zhu-chengdong/rov-v1-hardwarex/docs/author_confirmed_updates.md

# v0.1.1确认资料与更正

本版将既有作者确认写入说明，包括无屏蔽Cat5、两端T568B、PWM1—8位置、TELEM1、PM02配套线、10/16/14 AWG、M5端子、紧固件铜柱、左右相机、原套件与后来FFC、6×6标定板与3×3 GT板、人工选图及已有参数使用情况。默认功率、默认风扇和相机命令均沿用，不重复索取当前读数。

R9成本和原币来源已同步，6S电池为GBP147.26现价参考，历史GBP151保留。原温度数据、CAD和全部27项离线工程文件保持已有内容。本轮仅补齐说明、对应索引和原先缺失的元数据JSON，没有运行工程程序。
