zhu-chengdong/rov-v1-hardwarex/hardware/dxf_circle_coordinates.csv

设计文件 | 圆实体序号 | 圆心X_mm_文件坐标 | 圆心Y_mm_文件坐标 | 直径_mm_设计值 | 图层 | 文件SHA256 | 证据性质
中间第二层.dxf | 1 | 5.0 | -5.0 | 3.5 | 0 | e1be11a05163d77e4fd96c762ded78b1e10967b86603280863bbd9c125fb629a | DXF几何，非实测与公差
中间第二层.dxf | 2 | 105.0 | -5.0 | 3.5 | 0 | e1be11a05163d77e4fd96c762ded78b1e10967b86603280863bbd9c125fb629a | DXF几何，非实测与公差
中间第二层.dxf | 3 | 20.0 | -105.0 | 3.5 | 0 | e1be11a05163d77e4fd96c762ded78b1e10967b86603280863bbd9c125fb629a | DXF几何，非实测与公差
中间第二层.dxf | 4 | 105.0 | -105.0 | 3.5 | 0 | e1be11a05163d77e4fd96c762ded78b1e10967b86603280863bbd9c125fb629a | DXF几何，非实测与公差
中间第二层.dxf | 5 | 10.0 | -40.0 | 3.5 | 0 | e1be11a05163d77e4fd96c762ded78b1e10967b86603280863bbd9c125fb629a | DXF几何，非实测与公差
中间第二层.dxf | 6 | 58.5 | -40.0 | 3.500000000000014 | 0 | e1be11a05163d77e4fd96c762ded78b1e10967b86603280863bbd9c125fb629a | DXF几何，非实测与公差
中间第二层.dxf | 7 | 16.0 | -92.0 | 3.5 | 0 | e1be11a05163d77e4fd96c762ded78b1e10967b86603280863bbd9c125fb629a | DXF几何，非实测与公差
前盖板.dxf | 1 | 0.0 | 100.0 | 6.000000000000002 | 0 | 2d4afc3d615f69fe52117c536fb832e73912f7cb123064bd589a319040ec1ef5 | DXF几何，非实测与公差
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
