zhu-chengdong/rov-v1-hardwarex/hardware/wiring/V1_COMMUNICATION_CONTROL_ARCHITECTURE.png

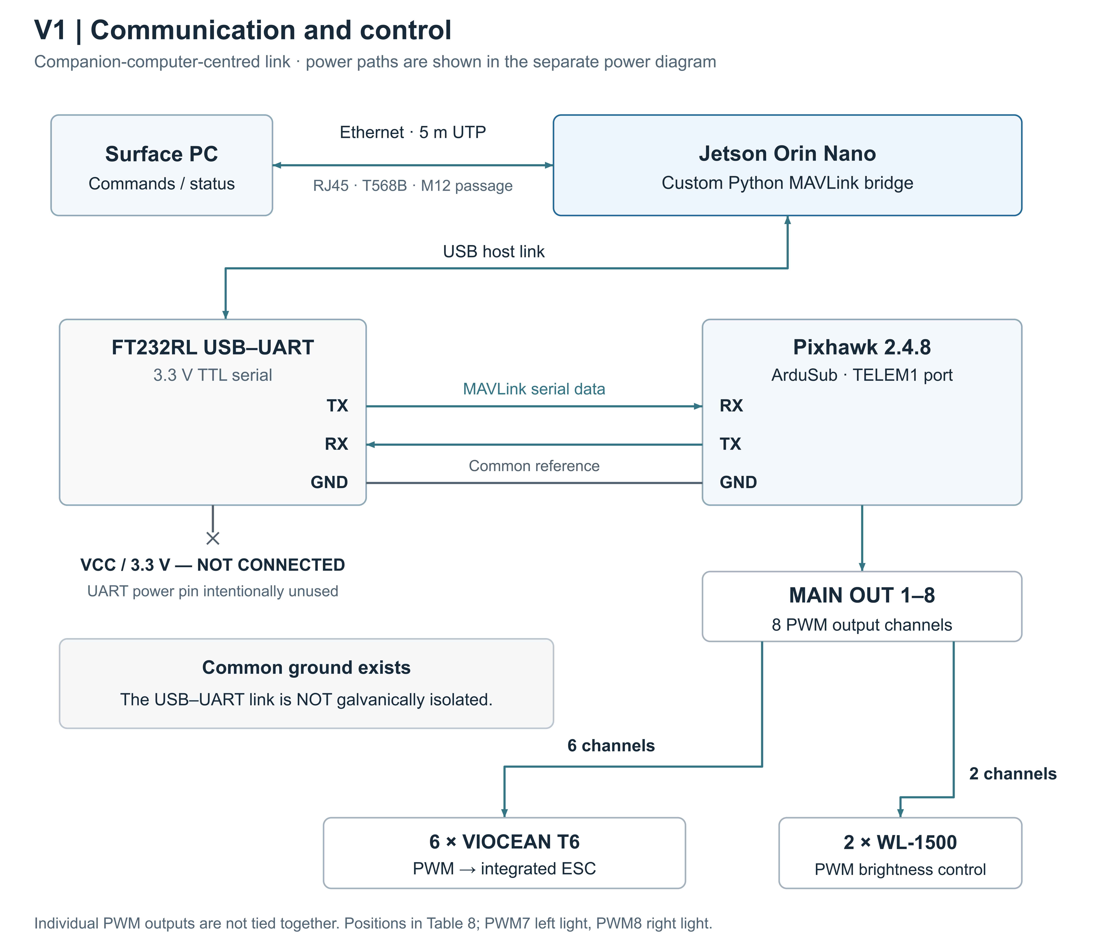
hardware/wiring/V1_COMMUNICATION_CONTROL_ARCHITECTURE.png
