zhu-chengdong/rov-v1-hardwarex/hardware/wiring/V1_POWER_ARCHITECTURE.png

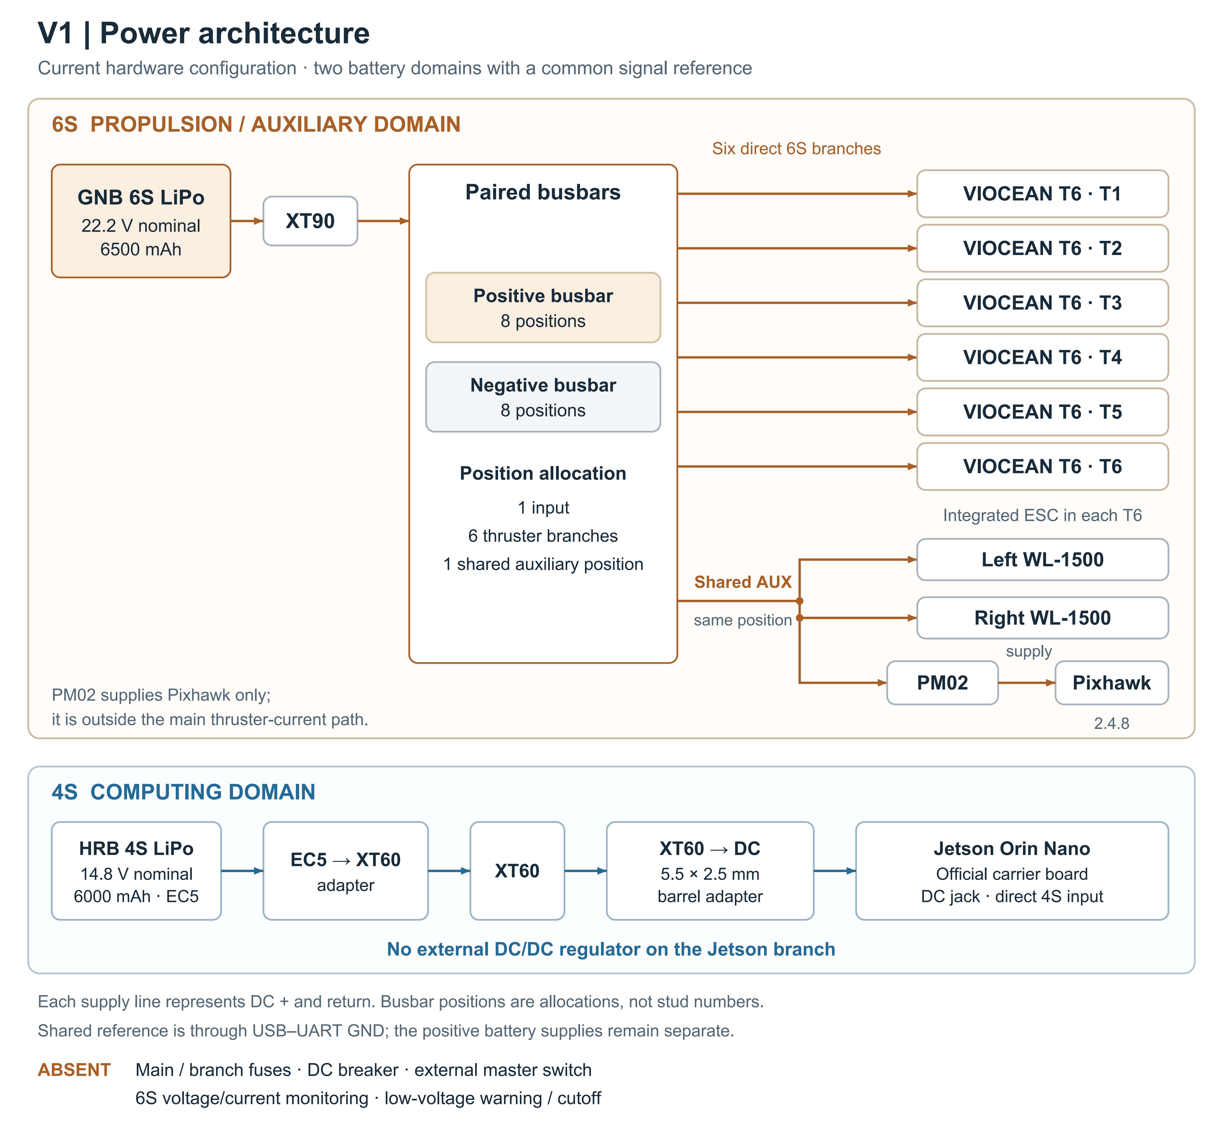
hardware/wiring/V1_POWER_ARCHITECTURE.png
