zhu-chengdong/rov-v1-hardwarex/docs/BOM.md

# R9成本与价格依据

正文、规格表及表3—7统一采用GBP。基础平台估算GBP1130.65；可选MTi-3增加GBP433.54；已列合计GBP1564.19。MTi-3不计入基础平台。地面PC和手柄、可复用工具、GT设施及未记录的额外USB、税运与工时单列。

沿用2026年11月3日ECB汇率，1 EUR对应GBP0.83358、CNY7.4590、USD1.1179。原币、计价组和包含关系见BOM_cost_basis.csv，本版合计按未舍入的原币换算值求和。

6S电池参考成本按作者本轮要求改为GBP147.26。来源为https://www.amazon.co.uk/dp/B0HJQRMZQK?th=1 的6S 6500mAh XT90选项，核对日期2026年11月3日。页面品牌为ZHGLIOZ、标题写For GNB，仅作为同规格现价参考；原GNB电池历史购价GBP151.00作为历史成本另行保留，不把现价改写成历史实付。

作者已确认C03近似CNY50、C12紧固件及铜柱整组CNY50、C30连接与固定耗材整组CNY100。Jetson学校渠道购价GBP189.94、B0266购价USD164.99、M10组合CNY194、M12件CNY27.16和可选MTi-3购价CNY3879.38均按已有回答登记。整组估算保持估算性质，不分摊为每颗螺母的实付金额。

本版v0.1.1更新成本及接线说明，旧版v0.1.0完整包保留原值。硬件正式DOI尚未建立，工程资料发布不表示论文已投稿。

| ID | Component | Quantity | Pricing unit | Line cost GBP | Price basis | Source | Material type |
|---|---|---|---|---|---|---|---|
| C01 | HMY亚克力舱、配套O-ring及前后端盖 | 1套 | 原物品或原费用组 | 66.374604 | 作者报告历史购价 | https://item.taobao.com/item.htm?id=583246672338 | 聚合物 |
| C02 | SLA树脂外框，5类8主件 | 1套 | 原物品或原费用组 | 95.999717 | 三笔SLA订单合计 | 淘宝代打印及嘉立创 | 聚合物 |
| C03 | 5 mm亚克力载荷架及双目架 | 1套 | 原物品或原费用组 | 5.587746 | 作者确认的近似加工费 | 商业激光切割，来源未记录；作者说明实际不到100元，按50元近似记录 | 聚合物 |
| C04 | 8 mm亚克力前盖，Ø220 | 1 | 并入C01 |  | 已计入C01 | 随C01，含现有全部开孔加工 | 聚合物 |
| C05 | 8 mm亚克力后盖，10×M10及中央M12 | 1 | 并入C01 |  | 已计入C01 | 随C01，含现有全部开孔加工 | 聚合物 |
| C06 | M10穿舱件组合，8空心加2封堵；空心通孔6.5 mm | 10件组合 | 原物品或原费用组 | 21.680456 | 作者确认购价 | https://item.taobao.com/item.htm?id=638960016847；作者本轮确认所列价格 | 非特定 |
| C07 | M10实心封堵，包含于C06 | 2 | 并入C06 |  | 已计入C06 | 同C06 | 非特定 |
| C08 | M12空心穿舱件，内部通孔8.5 mm | 1 | 原物品或原费用组 | 3.035264 | 作者确认购价 | https://item.taobao.com/item.htm?id=638960016847；作者本轮确认所列价格 | 非特定 |
| C09 | VIOCEAN MF-01环氧胶 | 包装数量待补 | 原物品或原费用组 | 9.247720 | 作者报告历史购价 | https://item.taobao.com/item.htm?id=583249268979 | 聚合物 |
| C10 | 316L M5×45端盖螺栓 | 16 | 并入C12 |  | 已计入C12 | 来源未记录 | 金属 |
| C11 | 316L M5螺母及垫片 | 16位置 | 并入C12 |  | 已计入C12 | 来源未记录 | 金属 |
| C12 | 结构紧固件与铜柱费用组 | 明细见表A.3 | 原物品或原费用组 | 5.587746 | 作者给定整组估算 | 来源未记录；螺丝、螺母及铜柱整组50元，作者估算 | 金属 |
| C13 | B0266，2×OV9281、原镜头及Camarray | 1套 | 原物品或原费用组 | 123.027430 | 作者确认购价 | https://www.arducam.com/arducam-1mp-stereo-camera-for-raspberry-pi-nvidia-jetson-nano-xavier-nx-dual-ov9281-monochrome-global-shutter-camera-module.html；作者确认USD164.99，不再仅标供应商报价 | 非特定 |
| C14 | B0266标准CSI及同步附件 | 1组 | 并入C13 |  | 已计入C13 | B0266套件随附；后购FFC来源 https://item.szlcsc.com/11651.html | 非特定 |
| C15 | Jetson Orin Nano 8GB开发套件 | 1套 | 原物品或原费用组 | 189.940000 | 作者确认学校折扣供货价 | 作者确认学校渠道供货商折扣价GBP189.94，原供应商金额已确认 | 非特定 |
| C16 | WD_BLACK SN7100 1TB NVMe | 1 | 原物品或原费用组 | 65.470000 | 作者报告历史购价 | 历史来源未记录 | 非特定 |
| C17 | GNB 6S 6500 mAh LiPo，XT90 | 1 | 原物品或原费用组 | 147.260000 | 2026-11-03现价参考 | Amazon 6S 6500mAh XT90选项，2026-11-03核价GBP147.26，https://www.amazon.co.uk/dp/B0HJQRMZQK?th=1；页面品牌ZHGLIOZ、标题For GNB，仅作同规格现价参考，不证明原GNB品牌身份；原台账历史购价GBP151.00保留于旧版 | 非特定 |
| C18 | HRB 4S 6000 mAh LiPo，EC5 | 1 | 原物品或原费用组 | 30.000000 | 作者报告历史购价 | Amazon历史购入 | 非特定 |
| C19 | EC5-to-XT60转接线 | 1 | 并入C30 |  | 已计入C30 | 同门代购 | 非特定 |
| C20 | XT60-to-DC5.5×2.5 mm兼容成品线，12 cm | 安装1 | 原物品或原费用组 | 1.536630 | 两条采购包等额分摊 | 来源未记录 | 非特定 |
| C21 | XT90母头10 AWG成品输入线 | 另购量待补 | 并入C30 |  | 已计入C30 | https://detail.tmall.com/item.htm?id=15100343646 | 非特定 |
| C22 | 正负8位M5配电铜排 | 1套 | 原物品或原费用组 | 15.042213 | 作者报告历史购价 | 淘宝，链接未记录 | 非特定 |
| C23 | Pixhawk 2.4.8兼容板，无GPS | 1 | 原物品或原费用组 | 44.143196 | 作者报告历史购价 | 淘宝，无明确品牌 | 非特定 |
| C24 | PM02 V3及配套POWER供电线 | 1套 | 原物品或原费用组 | 15.980955 | 作者报告历史购价 | 淘宝，厂牌待补 | 非特定 |
| C25 | T6集成ESC推进器，3正桨3反桨，直接固定框架 | 6 | 原物品或原费用组 | 167.434584 | 作者报告历史购价 | https://item.taobao.com/item.htm?id=583231725735 | 非特定 |
| C26 | WL-1500白光灯及随灯夹具 | 2 | 原物品或原费用组 | 79.624268 | 作者报告历史购价 | https://item.taobao.com/item.htm?id=663915287742 | 非特定 |
| C27 | FT232RL USB-UART，3.3 V TTL，1 m | 1 | 原物品或原费用组 | 2.648592 | 作者报告历史购价 | 来源未记录 | 非特定 |
| C28 | 无屏蔽防水五类以太网系缆 | 5 m | 原物品或原费用组 | 7.286421 | 作者报告历史购价 | 作者原来源 https://item.taobao.com/item.htm?id=542224330087；两端T568B | 非特定 |
| C29 | 超五类RJ45水晶头 | 安装2 | 并入C30 |  | 已计入C30 | https://detail.tmall.com/item.htm?id=17914441696；安装两只 | 非特定 |
| C30 | 连接器、导线、焊接热缩及固定耗材组 | 1组，整批计价 | 原物品或原费用组 | 11.175493 | 作者给定整组估算 | https://detail.tmall.com/item.htm?id=15100343646；https://detail.tmall.com/item.htm?id=742432916778；https://item.taobao.com/item.htm?id=843048972026；https://item.taobao.com/item.htm?id=687928659037&sku_properties=31309%3A3221908；未单列增量费用未记录；作者给定未单列线材、接头、端子、热缩与固定耗材整组100元，不按单颗螺母分摊 | 非特定 |
| C31 | 可移除双面胶及热熔胶 | 用量待补 | 并入C30 |  | 已计入C30 | 来源未记录 | 聚合物 |
| C32 | 名义100 g铅块，归档配平 | 17块 | 原物品或原费用组 | 22.570025 | 商品页推算 | 原页面来源未记录 | 金属 |
| C34 | WL-1500随灯夹具 | 2件 | 并入C26 |  | 已计入C26 | https://item.taobao.com/item.htm?id=663915287742 | 非特定 |
| O01 | Xsens MTi-3-8A7G6及USB接口 | 1套 | 原物品或原费用组 | 433.539828 | 作者报告购价 | 作者查得MTi-3原购价CNY3879.38；归属可选模块，不计机器人本体 | 非特定 |
| O02 | MTi-3三组M2.5×15铜柱及额外USB附件 | 铜柱3组；USB附件另核 | 未单列 |  | 未记录 | 三组固定铜柱按C12整批费用处理；额外USB附件未单列价格，不重复计算随附件 | 非特定 |
| S01 | MF-01配套胶枪 | 1 | 原物品或原费用组 | 1.493046 | 作者报告历史购价 | 来源待补 | 非特定 |
| S02 | 格氏智能充电器，支持2S—6S | 1台 | 原物品或原费用组 | 25.189561 | 作者报告历史购价 | 作者报告历史购入 | 非特定 |
| S03 | 地面PC及映射手柄 | 1套 | 未单列 |  | 未记录 | 实际使用XInput Controller #1；PC及手柄具体型号、费用待补 | 非特定 |
| S04 | RJ45压接、焊接和紧固工具 | 待补 | 未单列 |  | 未记录 | 来源待补 | 非特定 |
| S05 | 第二条XT60-to-DC线，备件 | 1 | 原物品或原费用组 | 1.536630 | 两条采购包等额分摊 | 同C20 | 非特定 |
| G01 | OV2311上方单目相机 | 1 | 未单列 |  | 未记录 | Arducam，套件SKU待补 | 非特定 |
| G02 | AprilTag阵列及板材 | 1组 | 未单列 |  | 未记录 | 制作来源待补 | 非特定 |
| G03 | 约0.7 m支撑杆及连接附件 | 4杆及附件 | 未单列 |  | 未记录 | 来源待补 | 非特定 |
| G04 | 临时砖块及铁丝 | 买3砖，用2 | 原物品或原费用组 | 0.223510 | 采购包约数，实用分摊未知 | 通用建材 | 非特定 |
| G05 | 实验网络交换机 | 1 | 未单列 |  | 未记录 | 型号和来源待补 | 非特定 |
| G06 | 水池及GT安装采集配套 | 范围待补 | 未单列 |  | 未记录 | 共用或借用归属待补 | 非特定 |
