zhu-chengdong/rov-v1-hardwarex/docs/BOM_cost_basis.csv

ID | 范围 | 部件 | 数量或计价单位 | 原币种 | 原币行金额 | 价格性质 | 费用归属 | 报告行金额_GBP | 来源
C01 | 基础平台 | HMY亚克力舱、配套O-ring及前后端盖 | 1套 | CNY | 593.93 | 作者报告历史购价 | 单列 | 66.374604 | https://item.taobao.com/item.htm?id=583246672338
C02 | 基础平台 | SLA树脂外框，5类8主件 | 1套 | CNY | 859.02 | 三笔SLA订单合计 | 单列 | 95.999717 | 淘宝代打印及嘉立创
C03 | 基础平台 | 5 mm亚克力载荷架及双目架 | 1套 | CNY | 50.0 | 作者确认的近似加工费 | 单列 | 5.587746 | 商业激光切割，来源未记录；作者说明实际不到100元，按50元近似记录
C04 | 基础平台 | 8 mm亚克力前盖，Ø220 | 1 |  |  | 已计入C01 | C01 |  | 随C01，含现有全部开孔加工
C05 | 基础平台 | 8 mm亚克力后盖，10×M10及中央M12 | 1 |  |  | 已计入C01 | C01 |  | 随C01，含现有全部开孔加工
C06 | 基础平台 | M10穿舱件组合，8空心加2封堵；空心通孔6.5 mm | 10件组合 | CNY | 194.0 | 作者确认购价 | 单列 | 21.680456 | https://item.taobao.com/item.htm?id=638960016847；作者本轮确认所列价格
C07 | 基础平台 | M10实心封堵，包含于C06 | 2 |  |  | 已计入C06 | C06 |  | 同C06
C08 | 基础平台 | M12空心穿舱件，内部通孔8.5 mm | 1 | CNY | 27.16 | 作者确认购价 | 单列 | 3.035264 | https://item.taobao.com/item.htm?id=638960016847；作者本轮确认所列价格
C09 | 基础平台 | VIOCEAN MF-01环氧胶 | 包装数量待补 | CNY | 82.75 | 作者报告历史购价 | 单列 | 9.247720 | https://item.taobao.com/item.htm?id=583249268979
C10 | 基础平台 | 316L M5×45端盖螺栓 | 16 |  |  | 已计入C12 | C12 |  | 来源未记录
C11 | 基础平台 | 316L M5螺母及垫片 | 16位置 |  |  | 已计入C12 | C12 |  | 来源未记录
C12 | 基础平台 | 结构紧固件与铜柱费用组 | 明细见表A.3 | CNY | 50.0 | 作者给定整组估算 | 单列 | 5.587746 | 来源未记录；螺丝、螺母及铜柱整组50元，作者估算
C13 | 基础平台 | B0266，2×OV9281、原镜头及Camarray | 1套 | USD | 164.99 | 作者确认购价 | 单列 | 123.027430 | https://www.arducam.com/arducam-1mp-stereo-camera-for-raspberry-pi-nvidia-jetson-nano-xavier-nx-dual-ov9281-monochrome-global-shutter-camera-module.html；作者确认U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
C14 | 基础平台 | B0266标准CSI及同步附件 | 1组 |  |  | 已计入C13 | C13 |  | B0266套件随附；后购FFC来源 https://item.szlcsc.com/11651.html
C15 | 基础平台 | Jetson Orin Nano 8GB开发套件 | 1套 | GBP | 189.94 | 作者确认学校折扣供货价 | 单列 | 189.940000 | 作者确认学校渠道供货商折扣价GBP189.94，原供应商金额已确认
C16 | 基础平台 | WD_BLACK SN7100 1TB NVMe | 1 | GBP | 65.47 | 作者报告历史购价 | 单列 | 65.470000 | 历史来源未记录
C17 | 基础平台 | GNB 6S 6500 mAh LiPo，XT90 | 1 | GBP | 147.26 | 2026-11-03现价参考 | 单列 | 147.260000 | Amazon 6S 6500mAh XT90选项，2026-11-03核价GBP147.26，https://www.amazon.co.uk/dp/B0HJQRMZQK?th=1；页面品牌ZHGLIOZ、标题For GNB，仅作同规格现价参考，不证明原GNB品牌身份；原台账历史购价GBP151.00保留于旧版
C18 | 基础平台 | HRB 4S 6000 mAh LiPo，EC5 | 1 | GBP | 30.0 | 作者报告历史购价 | 单列 | 30.000000 | Amazon历史购入
C19 | 基础平台 | EC5-to-XT60转接线 | 1 |  |  | 已计入C30 | C30 |  | 同门代购
C20 | 基础平台 | XT60-to-DC5.5×2.5 mm兼容成品线，12 cm | 安装1 | CNY | 13.75 | 两条采购包等额分摊 | 单列 | 1.536630 | 来源未记录
C21 | 基础平台 | XT90母头10 AWG成品输入线 | 另购量待补 |  |  | 已计入C30 | C30 |  | https://detail.tmall.com/item.htm?id=15100343646
C22 | 基础平台 | 正负8位M5配电铜排 | 1套 | CNY | 134.6 | 作者报告历史购价 | 单列 | 15.042213 | 淘宝，链接未记录
C23 | 基础平台 | Pixhawk 2.4.8兼容板，无GPS | 1 | CNY | 395.0 | 作者报告历史购价 | 单列 | 44.143196 | 淘宝，无明确品牌
C24 | 基础平台 | PM02 V3及配套POWER供电线 | 1套 | CNY | 143.0 | 作者报告历史购价 | 单列 | 15.980955 | 淘宝，厂牌待补
C25 | 基础平台 | T6集成ESC推进器，3正桨3反桨，直接固定框架 | 6 | CNY | 1498.23 | 作者报告历史购价 | 单列 | 167.434584 | https://item.taobao.com/item.htm?id=583231725735
C26 | 基础平台 | WL-1500白光灯及随灯夹具 | 2 | CNY | 712.49 | 作者报告历史购价 | 单列 | 79.624268 | https://item.taobao.com/item.htm?id=663915287742
C27 | 基础平台 | FT232RL USB-UART，3.3 V TTL，1 m | 1 | CNY | 23.7 | 作者报告历史购价 | 单列 | 2.648592 | 来源未记录
C28 | 基础平台 | 无屏蔽防水五类以太网系缆 | 5 m | CNY | 65.2 | 作者报告历史购价 | 单列 | 7.286421 | 作者原来源 https://item.taobao.com/item.htm?id=542224330087；两端T568B
C29 | 基础平台 | 超五类RJ45水晶头 | 安装2 |  |  | 已计入C30 | C30 |  | https://detail.tmall.com/item.htm?id=17914441696；安装两只
C30 | 基础平台 | 连接器、导线、焊接热缩及固定耗材组 | 1组，整批计价 | CNY | 100.0 | 作者给定整组估算 | 单列 | 11.175493 | https://detail.tmall.com/item.htm
C31 | 基础平台 | 可移除双面胶及热熔胶 | 用量待补 |  |  | 已计入C30 | C30 |  | 来源未记录
C32 | 基础平台 | 名义100 g铅块，归档配平 | 17块 | CNY | 201.96 | 商品页推算 | 单列 | 22.570025 | 原页面来源未记录
C34 | 基础平台 | WL-1500随灯夹具 | 2件 |  |  | 已计入C26 | C26 |  | https://item.taobao.com/item.htm?id=663915287742
O01 | 可选模块 | Xsens MTi-3-8A7G6及USB接口 | 1套 | CNY | 3879.38 | 作者报告购价 | 单列 | 433.539828 | 作者查得MTi-3原购价CNY3879.38；归属可选模块，不计机器人本体
O02 | 可选模块 | MTi-3三组M2.5×15铜柱及额外USB附件 | 铜柱3组；USB附件另核 |  |  | 未记录 | 缺价 |  | 三组固定铜柱按C12整批费用处理；额外USB附件未单列价格，不重复计算随附件
S01 | 地面与支持 | MF-01配套胶枪 | 1 | CNY | 13.36 | 作者报告历史购价 | 单列 | 1.493046 | 来源待补
S02 | 地面与支持 | 格氏智能充电器，支持2S—6S | 1台 | CNY | 225.4 | 作者报告历史购价 | 单列 | 25.189561 | 作者报告历史购入
S03 | 地面与支持 | 地面PC及映射手柄 | 1套 |  |  | 未记录 | 缺价 |  | 实际使用XInput Controller #1；PC及手柄具体型号、费用待补
S04 | 地面与支持 | RJ45压接、焊接和紧固工具 | 待补 |  |  | 未记录 | 缺价 |  | 来源待补
S05 | 地面与支持 | 第二条XT60-to-DC线，备件 | 1 | CNY | 13.75 | 两条采购包等额分摊 | 单列 | 1.536630 | 同C20
G01 | GT设施 | OV2311上方单目相机 | 1 |  |  | 未记录 | 缺价 |  | Arducam，套件SKU待补
G02 | GT设施 | AprilTag阵列及板材 | 1组 |  |  | 未记录 | 缺价 |  | 制作来源待补
G03 | GT设施 | 约0.7 m支撑杆及连接附件 | 4杆及附件 |  |  | 未记录 | 缺价 |  | 来源待补
G04 | GT设施 | 临时砖块及铁丝 | 买3砖，用2 | CNY | 2.0 | 采购包约数，实用分摊未知 | 单列 | 0.223510 | 通用建材
G05 | GT设施 | 实验网络交换机 | 1 |  |  | 未记录 | 缺价 |  | 型号和来源待补
G06 | GT设施 | 水池及GT安装采集配套 | 范围待补 |  |  | 未记录 | 缺价 |  | 共用或借用归属待补
