zhu-chengdong/rov-v1-hardwarex/hardware/manufacturing_2024_R1/孔槽名义尺寸与坐标_R1.csv

零件 | 编号 | 类型 | X_mm | Y_mm | 孔径或槽宽_mm | 槽总长_mm | 槽长轴向 | 原生模型坐标原点X_mm | 原生模型坐标原点Y_mm
前盖板 | H01 | 孔 | 100.0 | 0.0 | 6.0 |  | — | 0 | 0
前盖板 | H02 | 孔 | 70.710678119 | 70.710678119 | 6.0 |  | — | 0 | 0
前盖板 | H03 | 孔 | 0.0 | 100.0 | 6.0 |  | — | 0 | 0
前盖板 | H04 | 孔 | -70.710678119 | 70.710678119 | 6.0 |  | — | 0 | 0
前盖板 | H05 | 孔 | -100.0 | -0.0 | 6.0 |  | — | 0 | 0
前盖板 | H06 | 孔 | -70.710678119 | -70.710678119 | 6.0 |  | — | 0 | 0
前盖板 | H07 | 孔 | 0.0 | -100.0 | 6.0 |  | — | 0 | 0
前盖板 | H08 | 孔 | 70.710678119 | -70.710678119 | 6.0 |  | — | 0 | 0
后盖板 | H01 | 孔 | 100.0 | 0.0 | 6.0 |  | — | 0 | 0
后盖板 | H02 | 孔 | 70.710678119 | 70.710678119 | 6.0 |  | — | 0 | 0
后盖板 | H03 | 孔 | 0.0 | 100.0 | 6.0 |  | — | 0 | 0
后盖板 | H04 | 孔 | -70.710678119 | 70.710678119 | 6.0 |  | — | 0 | 0
后盖板 | H05 | 孔 | -100.0 | -0.0 | 6.0 |  | — | 0 | 0
后盖板 | H06 | 孔 | -70.710678119 | -70.710678119 | 6.0 |  | — | 0 | 0
后盖板 | H07 | 孔 | 0.0 | -100.0 | 6.0 |  | — | 0 | 0
后盖板 | H08 | 孔 | 70.710678119 | -70.710678119 | 6.0 |  | — | 0 | 0
后盖板 | H09 | 孔 | 61.818673559 | 20.086104634 | 10.2 |  | — | 0 | 0
后盖板 | H10 | 孔 | 38.206041399 | 52.586104634 | 10.2 |  | — | 0 | 0
后盖板 | H11 | 孔 | 0.0 | 65.0 | 10.2 |  | — | 0 | 0
后盖板 | H12 | 孔 | -38.206041399 | 52.586104634 | 10.2 |  | — | 0 | 0
后盖板 | H13 | 孔 | -61.818673559 | 20.086104634 | 10.2 |  | — | 0 | 0
后盖板 | H14 | 孔 | -61.818673559 | -20.086104634 | 10.2 |  | — | 0 | 0
后盖板 | H15 | 孔 | -38.206041399 | -52.586104634 | 10.2 |  | — | 0 | 0
后盖板 | H16 | 孔 | 0.0 | -65.0 | 10.2 |  | — | 0 | 0
后盖板 | H17 | 孔 | 38.206041399 | -52.586104634 | 10.2 |  | — | 0 | 0
后盖板 | H18 | 孔 | 61.818673559 | -20.086104634 | 10.2 |  | — | 0 | 0
后盖板 | H19 | 孔 | 0.0 | 0.0 | 12.2 |  | — | 0 | 0
盖板 | S01 | 槽 | 20.0 | 15.5 | 6.5 | 9.5 | Y | -90.0 | -23.0
盖板 | S02 | 槽 | 160.0 | 15.5 | 6.5 | 9.5 | Y | -90.0 | -23.0
盖板 | S03 | 槽 | 50.0 | 136.0 | 6.5 | 14.5 | Y | -90.0 | -23.0
盖板 | S04 | 槽 | 130.0 | 136.0 | 6.5 | 14.5 | Y | -90.0 | -23.0
盖板 | S05 | 槽 | 26.0 | 160.0 | 6.5 | 14.5 | X | -90.0 | -23.0
盖板 | H06 | 孔 | 50.0 | 160.0 | 6.5 |  | — | -90.0 | -23.0
盖板 | S07 | 槽 | 74.0 | 160.0 | 6.5 | 14.5 | X | -90.0 | -23.0
盖板 | S08 | 槽 | 106.0 | 160.0 | 6.5 | 14.5 | X | -90.0 | -23.0
盖板 | H09 | 孔 | 130.0 | 160.0 | 6.5 |  | — | -90.0 | -23.0
盖板 | S10 | 槽 | 154.0 | 160.0 | 6.5 | 14.5 | X | -90.0 | -23.0
盖板 | S11 | 槽 | 50.0 | 184.0 | 6.5 | 14.5 | Y | -90.0 | -23.0
盖板 | S12 | 槽 | 130.0 | 184.0 | 6.5 | 14.5 | Y | -90.0 | -23.0
盖板 | S13 | 槽 | 50.0 | 216.0 | 6.5 | 14.5 | Y | -90.0 | -23.0
盖板 | S14 | 槽 | 130.0 | 216.0 | 6.5 | 14.5 | Y | -90.0 | -23.0
盖板 | S15 | 槽 | 26.0 | 240.0 | 6.5 | 14.5 | X | -90.0 | -23.0
盖板 | H16 | 孔 | 50.0 | 240.0 | 6.5 |  | — | -90.0 | -23.0
盖板 | S17 | 槽 | 74.0 | 240.0 | 6.5 | 14.5 | X | -90.0 | -23.0
盖板 | S18 | 槽 | 106.0 | 240.0 | 6.5 | 14.5 | X | -90.0 | -23.0
盖板 | H19 | 孔 | 130.0 | 240.0 | 6.5 |  | — | -90.0 | -23.0
盖板 | S20 | 槽 | 154.0 | 240.0 | 6.5 | 14.5 | X | -90.0 | -23.0
盖板 | S21 | 槽 | 50.0 | 264.0 | 6.5 | 14.5 | Y | -90.0 | -23.0
盖板 | S22 | 槽 | 130.0 | 264.0 | 6.5 | 14.5 | Y | -90.0 | -23.0
盖板 | S23 | 槽 | 20.0 | 384.5 | 6.5 | 9.5 | Y | -90.0 | -23.0
盖板 | S24 | 槽 | 160.0 | 384.5 | 6.5 | 9.5 | Y | -90.0 | -23.0
最大的板子 | H01 | 孔 | 55.0 | 32.5 | 4.5 |  | — | 0.0 | 0.0
最大的板子 | H02 | 孔 | 95.0 | 32.5 | 4.5 |  | — | 0.0 | 0.0
最大的板子 | H03 | 孔 | 30.0 | 42.0 | 4.5 |  | — | 0.0 | 0.0
最大的板子 | H04 | 孔 | 120.0 | 42.0 | 4.5 |  | — | 0.0 | 0.0
最大的板子 | H05 | 孔 | 25.0 | 50.0 | 3.0 |  | — | 0.0 | 0.0
最大的板子 | H06 | 孔 | 125.0 | 50.0 | 3.0 |  | — | 0.0 | 0.0
最大的板子 | H07 | 孔 | 40.0 | 150.0 | 3.0 |  | — | 0.0 | 0.0
最大的板子 | H08 | 孔 | 125.0 | 150.0 | 3.0 |  | — | 0.0 | 0.0
最大的板子 | H09 | 孔 | 30.0 | 350.0 | 4.5 |  | — | 0.0 | 0.0
最大的板子 | H10 | 孔 | 120.0 | 350.0 | 4.5 |  | — | 0.0 | 0.0
中间第二层 | H01 | 孔 | 20.0 | 5.0 | 3.5 |  | — | 0.0 | -110.0
中间第二层 | H02 | 孔 | 105.0 | 5.0 | 3.5 |  | — | 0.0 | -110.0
中间第二层 | H03 | 孔 | 16.0 | 18.0 | 3.5 |  | — | 0.0 | -110.0
中间第二层 | H04 | 孔 | 10.0 | 70.0 | 3.5 |  | — | 0.0 | -110.0
中间第二层 | H05 | 孔 | 58.5 | 70.0 | 3.5 |  | — | 0.0 | -110.0
中间第二层 | H06 | 孔 | 5.0 | 105.0 | 3.5 |  | — | 0.0 | -110.0
中间第二层 | H07 | 孔 | 105.0 | 105.0 | 3.5 |  | — | 0.0 | -110.0
