zhu-chengdong/rov-v1-hardwarex/hardware/exports/盖板.step

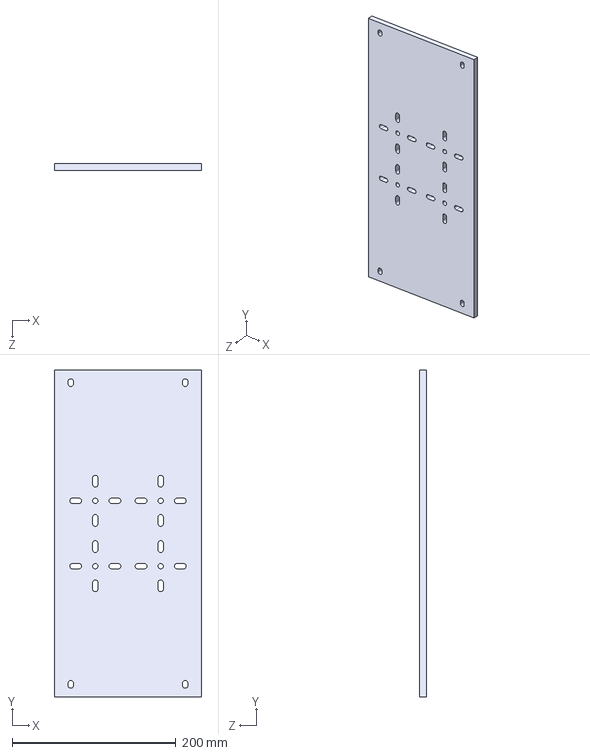
[picture p3: CAD file, 2026-11-04]
hardware/exports/盖板.step
180.0 x 400.0 x 8.00 mm
