zhu-chengdong/rov-v1-hardwarex/hardware/native_2018/圆弧形支撑板.sldprt

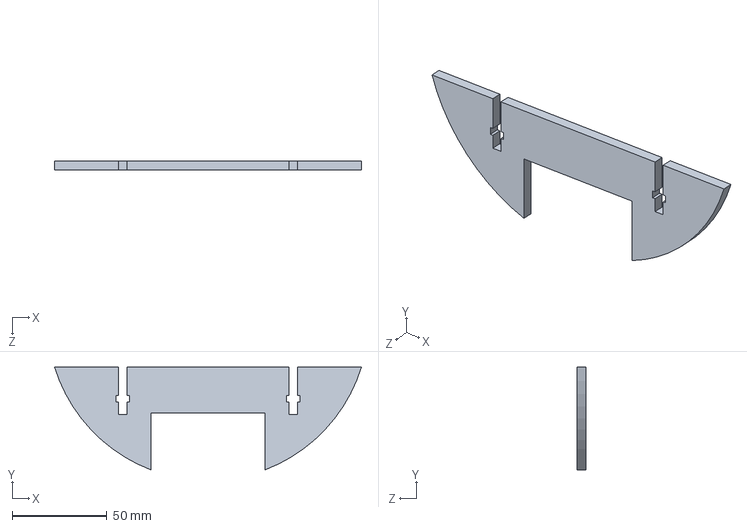
[picture p4: CAD file, 2026-11-04]
hardware/native_2018/圆弧形支撑板.sldprt
162.0 x 54.3 x 5.00 mm
