zhu-chengdong/rov-v1-hardwarex/hardware/exports/相机的支撑架.step

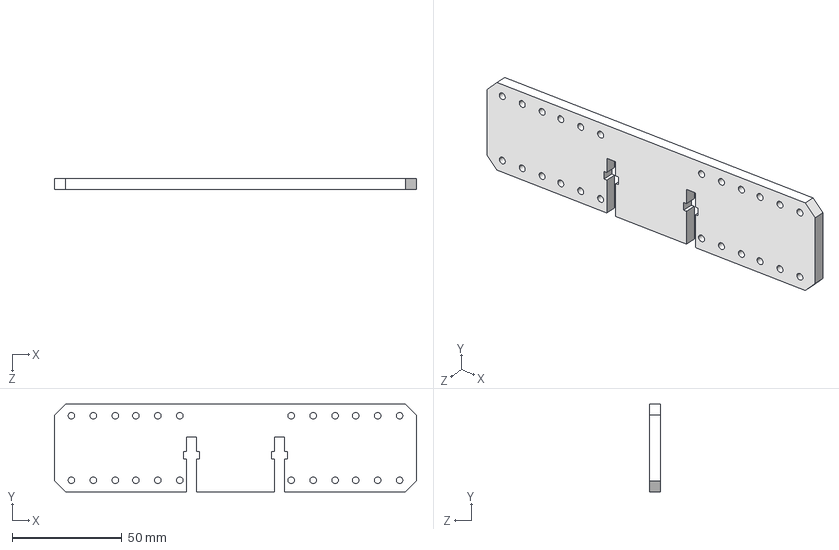
[picture p5: CAD file, 2026-11-04]
hardware/exports/相机的支撑架.step
164.7 x 40.0 x 5.00 mm
