zhu-chengdong/rov-v1-hardwarex/hardware/manufacturing_2024_R1/models/最大的板子.sldprt

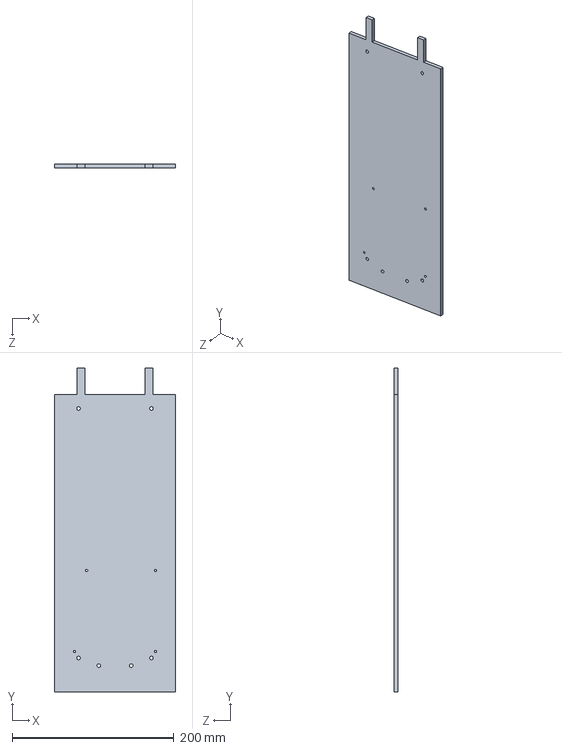
[picture p6: CAD file, 2026-11-04]
hardware/manufacturing_2024_R1/models/最大的板子.sldprt
150.0 x 400.0 x 5.00 mm
