zhu-chengdong/rov-v1-hardwarex/hardware/native_2018/后上支板.sldprt

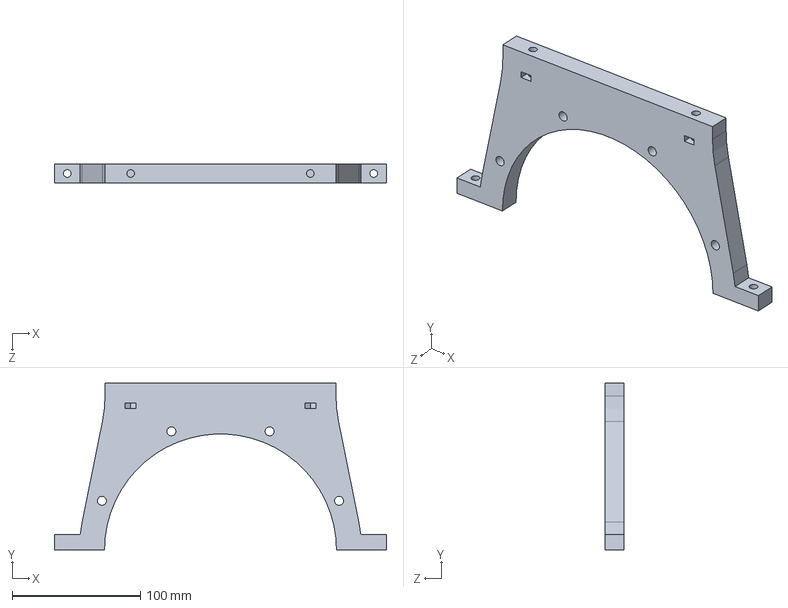
[picture p7: CAD file, 2026-11-04]
hardware/native_2018/后上支板.sldprt
258.7 x 130.0 x 15.0 mm
