zhu-chengdong/rov-v1-hardwarex/hardware/exports/中间第二层.step

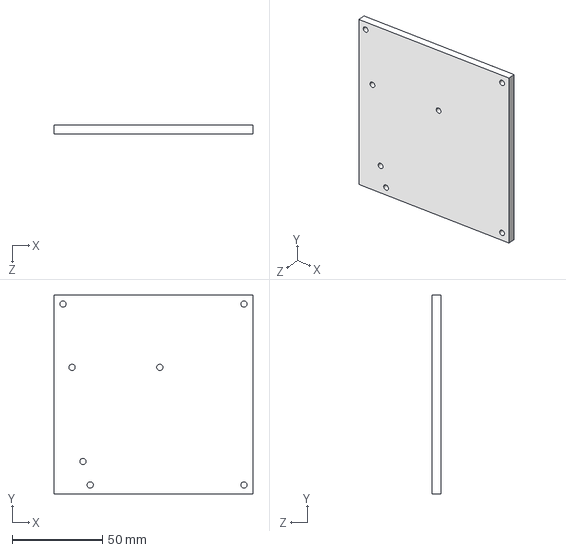
[picture p8: CAD file, 2026-11-04]
hardware/exports/中间第二层.step
110.0 x 110.0 x 5.00 mm
