zhu-chengdong/rov-v1-hardwarex/hardware/manufacturing_2024_R1/models/前盖板.sldprt

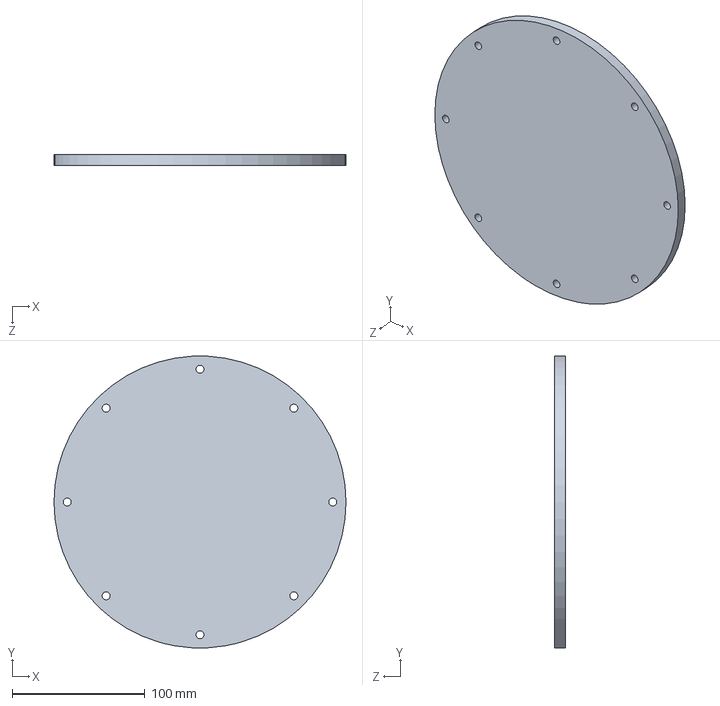
[picture p10: CAD file, 2026-11-04]
hardware/manufacturing_2024_R1/models/前盖板.sldprt
220.0 x 219.6 x 8.00 mm
