zhu-chengdong/rov-v1-hardwarex/hardware/native_2018/底板.sldprt

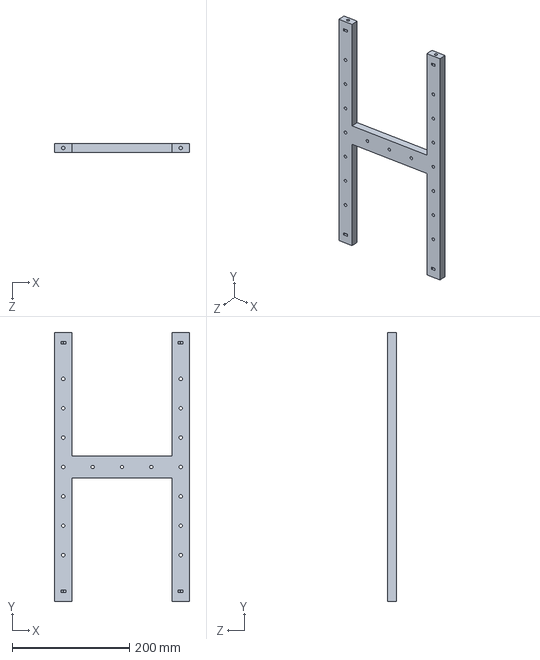
[picture p11: CAD file, 2026-11-04]
hardware/native_2018/底板.sldprt
230.0 x 458.0 x 15.0 mm
