zhu-chengdong/rov-v1-hardwarex/hardware/exports/后下支板.step

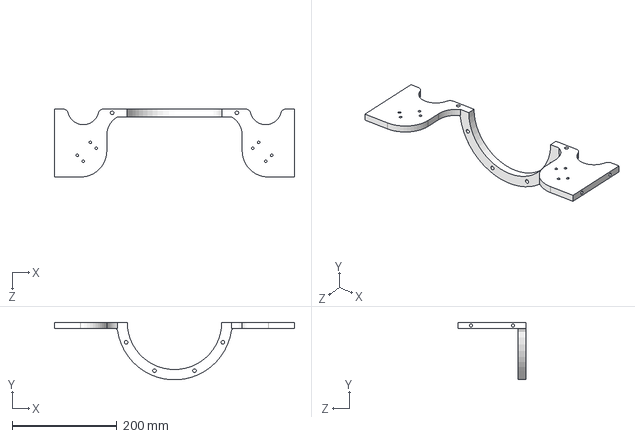
[picture p12: CAD file, 2026-11-04]
hardware/exports/后下支板.step
458.7 x 109.8 x 130.0 mm
