zhu-chengdong/rov-v1-hardwarex/hardware/native_2018/侧边挡板.sldprt

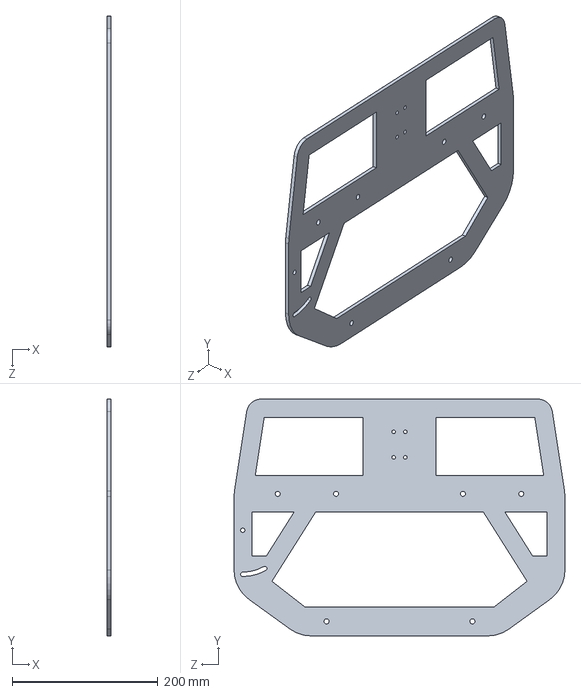
[picture p13: CAD file, 2026-11-04]
hardware/native_2018/侧边挡板.sldprt
5.00 x 325.0 x 454.0 mm
