zhu-chengdong/rov-v1-hardwarex/(list of files, cad)

Other CAD files:
hardware/manufacturing_2024_R1/models/盖板.sldprt
hardware/native_2018/相机的支撑架.sldprt
hardware/exports/后盖板.step
hardware/native_2018/后盖板.sldprt
hardware/exports/后上支板.step
hardware/manufacturing_2024_R1/models/中间第二层.sldprt
hardware/exports/最大的板子.step
hardware/native_2018/盖板.sldprt
hardware/native_2018/最大的板子.sldprt
hardware/exports/前盖板.step
hardware/exports/侧边挡板.step
hardware/native_2018/后下支板.sldprt
hardware/exports/底板.step
hardware/native_2018/前盖板.sldprt
hardware/exports/圆弧形支撑板.step
hardware/native_2018/中间第二层.sldprt
hardware/exports/中间第二层.dxf
hardware/exports/侧边挡板.stl
hardware/exports/前盖板.dxf
hardware/exports/后上支板.stl
hardware/exports/后下支板.stl
hardware/exports/后盖板.dxf
hardware/exports/圆弧形支撑板.dxf
hardware/exports/底板.stl
hardware/exports/最大的板子.dxf
hardware/exports/盖板.stl
hardware/exports/相机的支撑架.dxf
hardware/manufacturing_2024_R1/native/中间第二层_2024_R1.SLDDRW
hardware/manufacturing_2024_R1/native/前盖板_2024_R1.SLDDRW
hardware/manufacturing_2024_R1/native/后盖板_2024_R1.SLDDRW
hardware/manufacturing_2024_R1/native/最大的板子_2024_R1.SLDDRW
hardware/manufacturing_2024_R1/native/盖板_2024_R1.SLDDRW
