zhu-chengdong/rov-v1-hardwarex/docs/manufacturing_fit.md

# 五张制造图的配合与复用说明

本说明对应既有R1名义几何及作者确认的装配关系。图纸的已有冷加载和重建结果沿用2026年10月31日报告，不记作本次重新重建。

作者已经明确未另行规定加工公差。本说明把可以确定的接口、名义尺寸和装配关系补齐；一般公差、形位要求和实测加工精度均不补造。

| 设计ID | 图纸 | BOM | 材料工艺数量 | 已核实名义几何 | 实装关系 | 名义算术 | 复用说明 | 依据 |
|---|---|---|---|---|---|---|---|---|
| D06 | 前盖板 | C04/C01 | 透明亚克力，t8，1件 | Ø220；8×Ø6，PCD200，首孔0°，45°均布 | 端盖配套M5×45；无中央孔 | 孔Ø6与M5的名义直径差1.0 mm，径向0.5 mm | 沿用商购舱体配套端盖、O-ring和压紧结构；未设公差不能据名义尺寸独立反推密封件 | 几何来自R1/PDF/孔表；M5来自作者确认 |
| D05 | 后盖板 | C05/C01/C06/C08 | 亚克力，t8，1件 | Ø220；8×Ø6/PCD200；10×Ø10.2/PCD130首孔18°；中央Ø12.2 | 8空心M10+2封堵，中央空心M12；每端8个M5×45 | Ø10.2对名义M10、Ø12.2对名义M12的直径差均0.2 mm | Ø6.5/8.5是穿线件内部通孔；Ø10.2/12.2是后盖安装孔；密封适配线径由具体商品确定 | 名义几何与作者实装分别记录 |
| D14 | 盖板 | C02 | SLA树脂，t8，1件 | 400×180；4×Ø6.5；20槽宽6.5，16槽总长14.5、4槽总长9.5，端R3.25 | 外框盖板；孔槽不据孔宽自动判定紧固件规格 | 长槽总长包括两端半圆，不能再加两倍半径 | 厂家已做打磨；历史树脂批次不统一指定；实际孔槽与连接件对应按装配位置核对 | R1孔槽表和预览已阅 |
| D08 | 最大的板子 | C03/C12 | 5 mm亚克力，激光切割，1件 | 150×400；6×Ø4.5及4×Ø3.0，12点外轮廓 | 6个Ø4.5对应4套圆弧支承及2套相机支撑M4×30；4孔对应中间层铜柱 | Ø4.5对名义M4直径差0.5 mm；Ø3.0对名义M3直径差0 mm | 主板Ø3.0是原设计名义值，不能写成有0.5 mm间隙，也不擅自改孔；切割补偿及装配处理未形成记录 | 六套M4连接为作者确认，四孔几何独立重算 |
| D09 | 中间第二层 | C03/C12/O02 | 5 mm亚克力，激光切割，1件 | 110×110；7×Ø3.5 | 4根M3×45母母铜柱；剩余3孔与可选IMU3组铜柱数量对应 | Ø3.5对名义M3直径差0.5 mm | 四孔与主板经坐标换算一致；剩余3孔只确认数量关系，没有新测IMU孔对位 | R1孔表及作者铜柱规格 |

## 坐标与孔数

五张制造图的孔表共48个圆孔和20个长圆槽，按前盖8孔、后盖19孔、盖板4孔20槽、主板10孔、中层7孔分别统计。六份DXF的68个圆孔是另一文件集合，其中包含相机支架24孔，不含SLA盖板的20槽；两个“68”不能混用。

中间层图纸左下角为原点，换到主板局部图纸坐标时采用X主=X中+20、Y主=155−Y中，四孔逐项对应见manufacturing_fit.csv与middle_main_hole_mapping.csv。Y方向反转用于描述两个局部面坐标的对应，并非改变零件孔群或重新测量装配位姿。

## 需要在使用说明中保留的区别

名义孔径差是算术值，不是公差带、配合等级或实际间隙测量。主板4×Ø3.0配M3端部紧固尤其应保持这一点。孔表保留三位小数只用于表示坐标，不能据此写成±0.001 mm制造要求。

端盖来自商购匹配舱体，配套O-ring及密封结构一起使用。穿线件安装孔、内部通孔和厂家适配电缆外径分别记录。MF-01胶枪灌封、通常隔日下水、纸巾清洁、定期硅脂和对角分轮紧固沿用作者已确认做法。

新制件可按以下功能项目进行装配检查。这些属于复用检查建议，并非V1新增实验或已有检验记录。

- 端盖与商购舱体的孔位能够对应，配套密封件完整贴合，孔边没有妨碍密封的毛刺、崩边或裂纹。
- 穿线件能按配套结构压紧，线缆与密封接触关系符合具体型号说明。
- 内架四根铜柱与主板孔组对应，装入时不以强行弯曲亚克力纠正孔位；CSI和供电接口保留装配路径。
- SLA盖板的孔槽与既有模型对应，连接件能够穿过并正常夹紧；不以未经记录的扩孔或尺寸修改代替原图。

现有R1仍保留审阅版标识。异机移动目录后的原生依赖重新定位没有实测，本轮只核对源包中五张图与五个配套模型齐全，不宣称已经验证跨机路径独立。2018原件、R1和HAT状态均保持原样。
