zhu-chengdong/rov-v1-hardwarex/validation/thermal/raw/underwater_05m_20261014_181314.csv

timestamp | tj_C | CPU_C | GPU_C | SOC0_C | SOC1_C | SOC2_C
2026-10-14T18:13:19+01:00 | 50.156 | 50.156 | 49.75 | 48.156 | 49.343 | 49.593
2026-10-14T18:13:24+01:00 | 50.281 | 50.281 | 50 | 48.125 | 49.437 | 49.656
2026-10-14T18:13:29+01:00 | 50.437 | 50.437 | 49.875 | 48.156 | 49.562 | 49.562
2026-10-14T18:13:34+01:00 | 50.5 | 50.5 | 49.968 | 48.281 | 49.281 | 49.625
2026-10-14T18:13:39+01:00 | 50.218 | 49.937 | 50.218 | 48.031 | 49.281 | 49.5
2026-10-14T18:13:44+01:00 | 50 | 50 | 49.718 | 48.031 | 49.406 | 49.375
2026-10-14T18:13:49+01:00 | 50.125 | 50.125 | 49.625 | 48.062 | 49.281 | 49.375
2026-10-14T18:13:54+01:00 | 50.093 | 50.093 | 49.625 | 48.156 | 49.406 | 49.468
2026-10-14T18:13:59+01:00 | 50.031 | 50.156 | 49.75 | 48.25 | 49.218 | 49.343
2026-10-14T18:14:04+01:00 | 49.906 | 49.906 | 49.906 | 47.906 | 49.187 | 49.375
2026-10-14T18:14:09+01:00 | 49.937 | 49.937 | 49.562 | 48.062 | 49.187 | 49.437
2026-10-14T18:14:14+01:00 | 49.968 | 49.937 | 49.968 | 47.968 | 49.25 | 49.218
2026-10-14T18:14:19+01:00 | 49.75 | 49.75 | 49.5 | 48.093 | 49.375 | 49.281
2026-10-14T18:14:24+01:00 | 49.718 | 49.718 | 49.593 | 47.843 | 49.093 | 49.25
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
