zhu-chengdong/rov-v1-hardwarex/validation/thermal/statistics/AIR_20261014_190802_fixed_5min_bins.csv

run_id | bin_start_s | bin_nominal_end_s | n | tj_mean_C | tj_min_C | tj_max_C
AIR_20261014_190802 | 0 | 300 | 60 | 49.54756666666667 | 49.25 | 50.312
AIR_20261014_190802 | 300 | 600 | 60 | 50.52675 | 49.843 | 51.125
AIR_20261014_190802 | 600 | 900 | 60 | 51.09748333333334 | 50.593 | 51.718
AIR_20261014_190802 | 900 | 1200 | 60 | 51.49438333333333 | 51.187 | 52.0
AIR_20261014_190802 | 1200 | 1500 | 60 | 51.367866666666664 | 51.062 | 51.875
AIR_20261014_190802 | 1500 | 1800 | 60 | 51.65476666666667 | 51.281 | 52.125
AIR_20261014_190802 | 1800 | 2100 | 60 | 51.89965 | 51.593 | 52.5
AIR_20261014_190802 | 2100 | 2400 | 60 | 52.16003333333333 | 51.781 | 52.687
AIR_20261014_190802 | 2400 | 2700 | 60 | 52.4335 | 52.093 | 52.968
AIR_20261014_190802 | 2700 | 3000 | 60 | 52.41838333333333 | 52.062 | 52.906
AIR_20261014_190802 | 3000 | 3300 | 60 | 52.369416666666666 | 52.125 | 52.781
AIR_20261014_190802 | 3300 | 3600 | 60 | 52.45325 | 52.125 | 52.812
AIR_20261014_190802 | 3600 | 3900 | 60 | 52.54593333333333 | 52.343 | 52.937
AIR_20261014_190802 | 3900 | 4200 | 60 | 53.23195 | 52.781 | 53.718
AIR_20261014_190802 | 4200 | 4500 | 60 | 53.46576666666667 | 53.218 | 53.875
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
