zhu-chengdong/rov-v1-hardwarex/validation/thermal/statistics/AIR_20261014_190802_tegrastats_fields.csv

source_log_line | timestamp | tj_C | CPU_C | GPU_C | SOC0_C | SOC1_C | SOC2_C | cpu_mean_utilization_pct | cpu_frequency_min_mhz | cpu_frequency_max_mhz | cpu_frequency_list_mhz | cpu_utilization_list_pct | gpu_utilization_pct | gpu_frequency_literal | ram_used_mb | CV0_literal_C | CV1_literal_C | CV2_literal_C
3 | 2026-10-14T19:08:07+01:00 | 49.656 | 49.625 | 49.656
4 | 2026-10-14T19:08:12+01:00 | 49.562 | 49.562 | 49.156
5 | 2026-10-14T19:08:17+01:00 | 49.656 | 49.5 | 49.656
6 | 2026-10-14T19:08:22+01:00 | 49.375 | 49.375 | 49.156
7 | 2026-10-14T19:08:27+01:00 | 49.812 | 49.375 | 49.093
8 | 2026-10-14T19:08:32+01:00 | 49.281 | 49.281 | 49.187
9 | 2026-10-14T19:08:37+01:00 | 49.281 | 49.25 | 49.281
10 | 2026-10-14T19:08:42+01:00 | 49.437 | 49.375 | 49.218
11 | 2026-10-14T19:08:47+01:00 | 49.656 | 49.656 | 49.25
12 | 2026-10-14T19:08:52+01:00 | 49.312 | 49.656 | 49.218
13 | 2026-10-14T19:08:57+01:00 | 49.312 | 49.312 | 49.062
14 | 2026-10-14T19:09:02+01:00 | 49.5 | 49.281 | 49.5
15 | 2026-10-14T19:09:07+01:00 | 49.312 | 49.312 | 49.062
16 | 2026-10-14T19:09:12+01:00 | 49.531 | 49.531 | 49.281
17 | 2026-10-14T19:09:17+01:00 | 49.593 | 49.593 | 49.437
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
