zhu-chengdong/rov-v1-hardwarex/validation/thermal/statistics/AIR_20261014_190802_temperature_source_data.csv

source_csv_line | timestamp | tj_C | CPU_C | GPU_C | SOC0_C | SOC1_C | SOC2_C | elapsed_s
2 | 2026-10-14T19:08:07+01:00 | 49.656 | 49.625 | 49.656 | 47.375 | 48.843 | 48.781 | 0.0
3 | 2026-10-14T19:08:12+01:00 | 49.562 | 49.562 | 49.156 | 47.687 | 48.906 | 48.906 | 5.0
4 | 2026-10-14T19:08:17+01:00 | 49.656 | 49.5 | 49.656 | 47.375 | 48.718 | 48.968 | 10.0
5 | 2026-10-14T19:08:22+01:00 | 49.375 | 49.375 | 49.156 | 47.5 | 48.718 | 48.937 | 15.0
6 | 2026-10-14T19:08:27+01:00 | 49.812 | 49.375 | 49.093 | 47.5 | 48.843 | 48.875 | 20.0
7 | 2026-10-14T19:08:32+01:00 | 49.281 | 49.281 | 49.187 | 47.687 | 49.031 | 48.812 | 25.0
8 | 2026-10-14T19:08:37+01:00 | 49.281 | 49.25 | 49.281 | 47.406 | 48.687 | 48.906 | 30.0
9 | 2026-10-14T19:08:42+01:00 | 49.437 | 49.375 | 49.218 | 47.468 | 48.812 | 48.875 | 35.0
10 | 2026-10-14T19:08:47+01:00 | 49.656 | 49.656 | 49.25 | 47.5 | 48.906 | 48.781 | 40.0
11 | 2026-10-14T19:08:52+01:00 | 49.312 | 49.656 | 49.218 | 47.656 | 48.656 | 48.843 | 45.0
12 | 2026-10-14T19:08:57+01:00 | 49.312 | 49.312 | 49.062 | 47.406 | 48.843 | 48.937 | 50.0
13 | 2026-10-14T19:09:02+01:00 | 49.5 | 49.281 | 49.5 | 47.593 | 49.031 | 48.812 | 55.0
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
