zhu-chengdong/rov-v1-hardwarex/CHANGELOG.md

# 版本记录

## v0.1.1 — 2026年11月4日

- 更新46项BOM及原币成本依据，统一GBP报告金额，区分基础平台、可选MTi-3、地面设备、工具及GT设施。
- 更新作者已确认的UTP Cat5、T568B、推进器及灯光通道、相机排线与左右关系，并使接线图和说明对应。
- 增补五张制造图的名义配合说明、紧固件表、中层四孔与主板对应及输出通道表，保持所有CAD几何不变。
- 区分三轮标定与两种图像导出方式，补充程序输入输出、副作用、原始与已校正参数的对应及可移植目录布局。
- 补齐PATH_CLEANUP.json、imports_by_file.json和dependencies_observed.json；观察环境与Jetson实际环境分开记录。
- 将完整源包139个文件提供为ZIP和可直接浏览的仓库文件；保留v0.1.0 ZIP原字节及历史提交。
- 沿用CERN-OHL-P-2.0、MIT和CC BY 4.0许可，不公开商购参考模型、私有历史、ROS bag、论文草稿或实物照片和视频。
- 原始CAD、作者程序及温度数据保持原值。本次没有补实验、设备读数或清洁环境端到端复现。

## v0.1.0 — 2026年11月2日

最初公开125文件工程源包，固定提交0897b234fac709542c385ab6d9ef04d38ec13119。
