zhu-chengdong/rov-v1-hardwarex/hardware/manufacturing_2024_R1/pdf/中间第二层_2024_R1.pdf

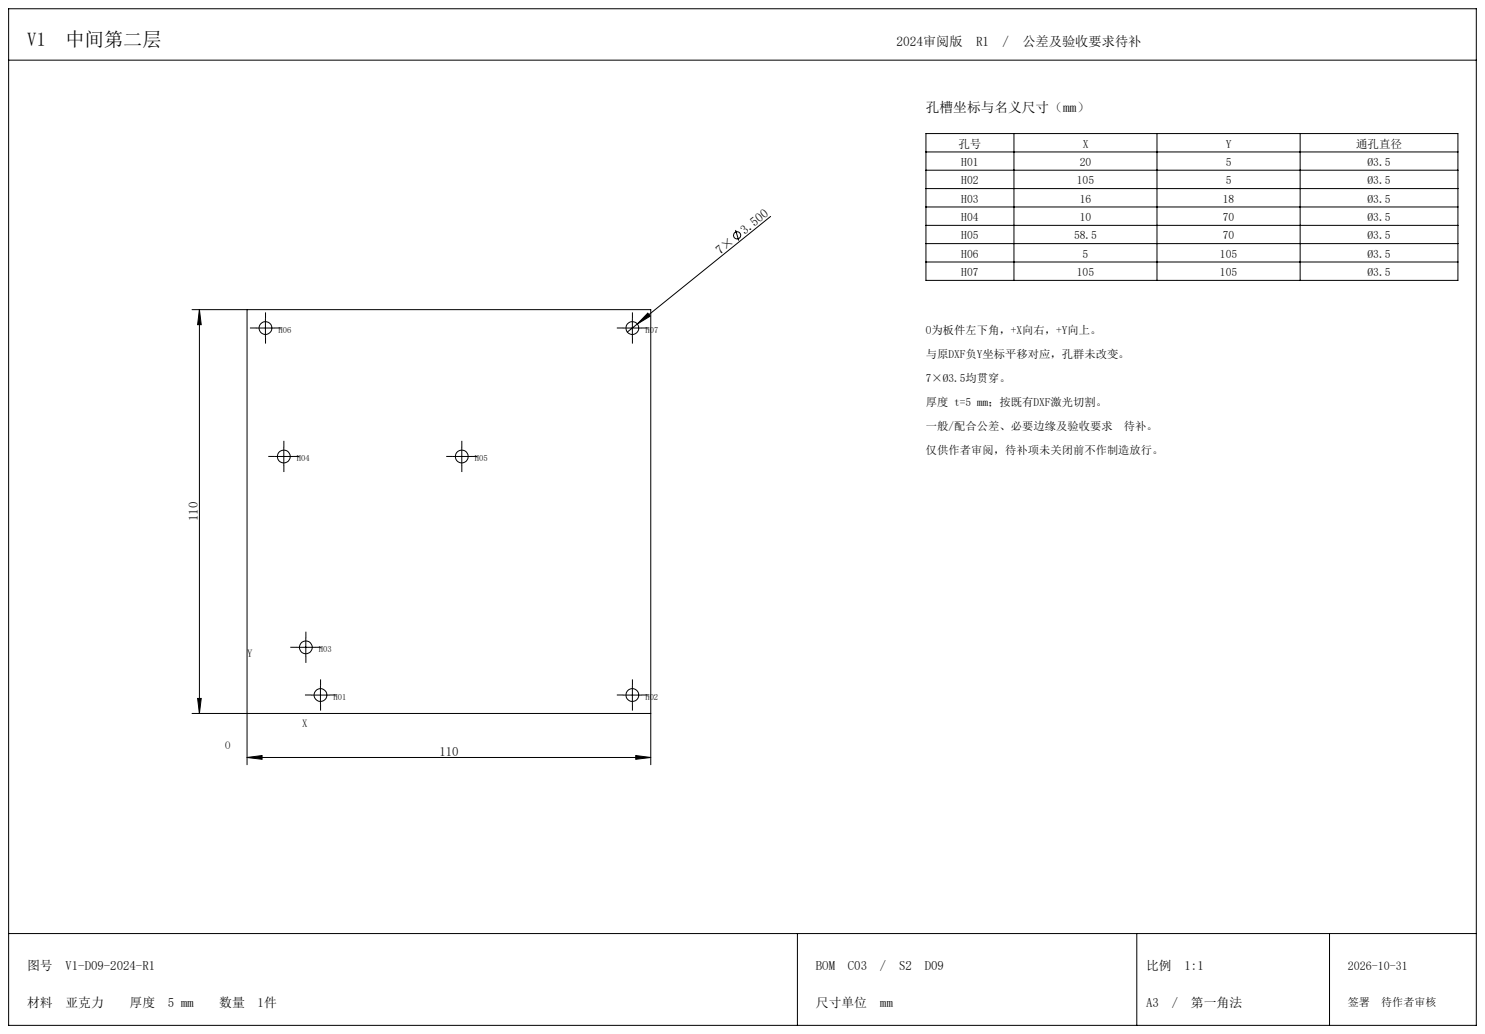
[picture p14: page 1]
V1 中间第二层; 2024审阅版 R1 / 公差及验收要求待补; 材料 亚克力; BOM C03 / S2 D09; 尺寸单位 mm; A3 / 第一角法; 签署 待作者审核

孔号 | X | Y | 通孔直径
H01 | 20 | 5 | Ø3.5
H02 | 105 | 5 | Ø3.5
H03 | 16 | 18 | Ø3.5
H04 | 10 | 70 | Ø3.5
H05 | 58.5 | 70 | Ø3.5
H06 | 5 | 105 | Ø3.5
H07 | 105 | 105 | Ø3.5

O为板件左下角，+X向右，+Y向上。

厚度 t=5 mm；按既有DXF激光切割。

一般/配合公差、必要边缘及验收要求 待补。
