zhu-chengdong/rov-v1-hardwarex/hardware/manufacturing_2024_R1/pdf/前盖板_2024_R1.pdf

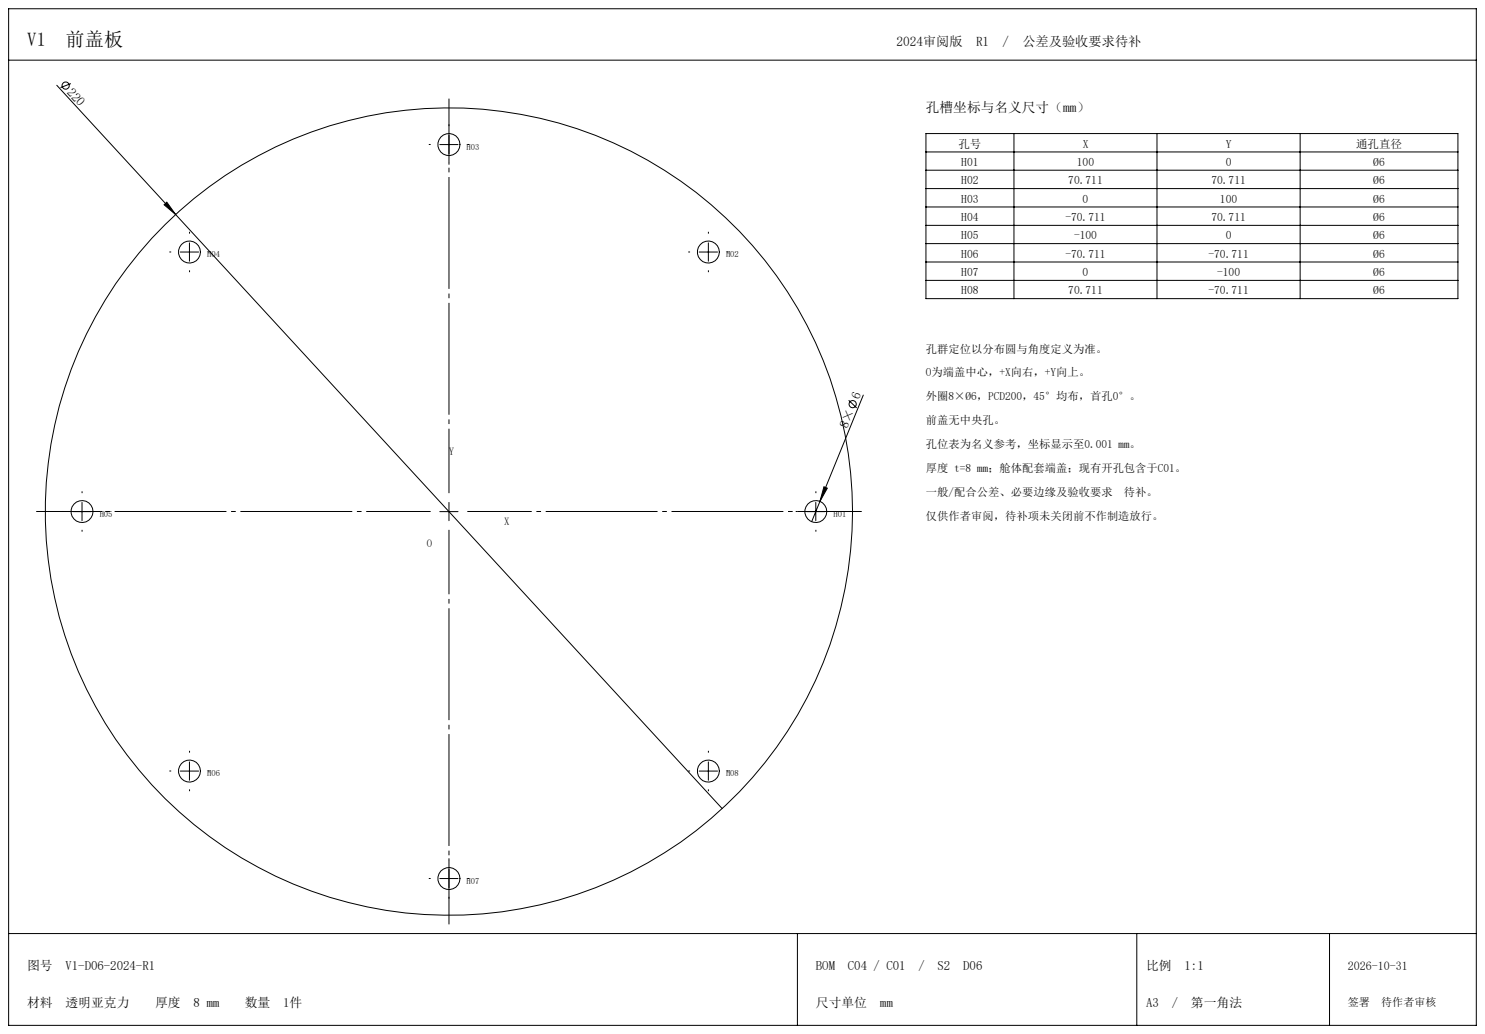
[picture p15: page 1]
V1 前盖板; 2024审阅版 R1 / 公差及验收要求待补; 材料 透明亚克力; BOM C04 / C01 / S2 D06; 尺寸单位 mm; A3 / 第一角法; 签署 待作者审核; 孔位表为名义参考，坐标显示至0.001 mm。

孔号 | X | Y | 通孔直径
H01 | 100 | 0 | Ø6
H02 | 70.711 | 70.711 | Ø6
H03 | 0 | 100 | Ø6
H04 | -70.711 | 70.711 | Ø6
H05 | -100 | 0 | Ø6
H06 | -70.711 | -70.711 | Ø6
H07 | 0 | -100 | Ø6
H08 | 70.711 | -70.711 | Ø6

O为端盖中心，+X向右，+Y向上。

厚度 t=8 mm；舱体配套端盖；现有开孔包含于C01。

一般/配合公差、必要边缘及验收要求 待补。
