zhu-chengdong/rov-v1-hardwarex/hardware/manufacturing_2024_R1/pdf/盖板_2024_R1.pdf

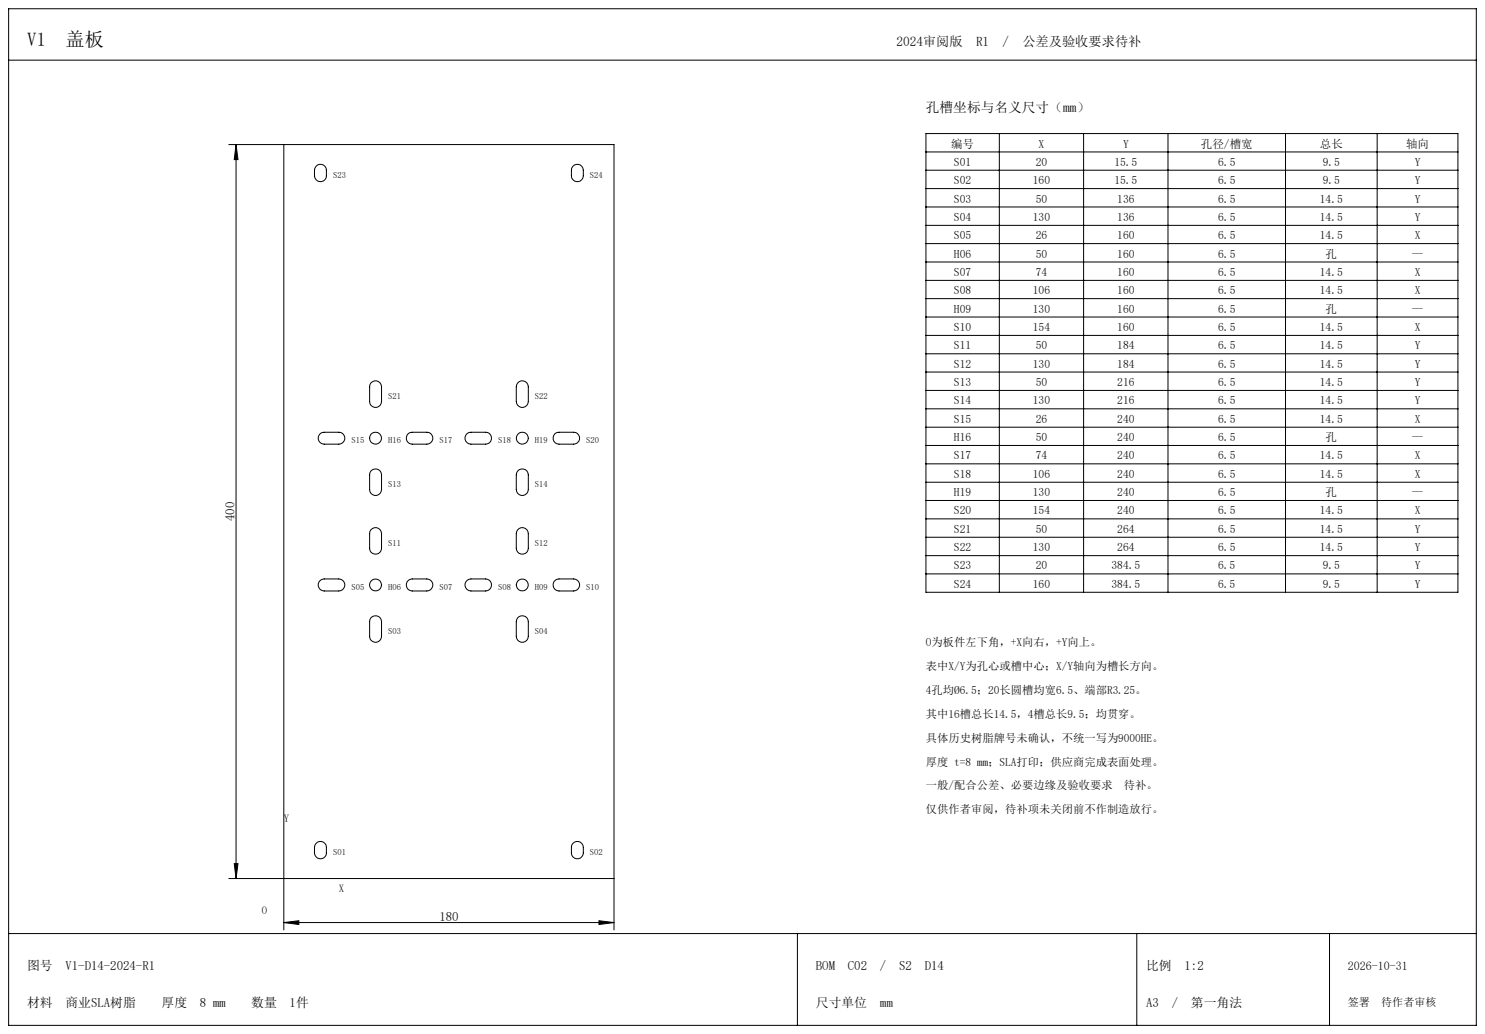
[picture p17: page 1]
2024审阅版 R1 / 公差及验收要求待补; 材料 商业SLA树脂; BOM C02 / S2 D14; 尺寸单位 mm; A3 / 第一角法; 签署 待作者审核

O为板件左下角，+X向右，+Y向上。

表中X/Y为孔心或槽中心；X/Y轴向为槽长方向。

厚度 t=8 mm；SLA打印；供应商完成表面处理。

一般/配合公差、必要边缘及验收要求 待补。
