zhu-chengdong/rov-v1-hardwarex/hardware/manufacturing_2024_R1/pdf/最大的板子_2024_R1.pdf

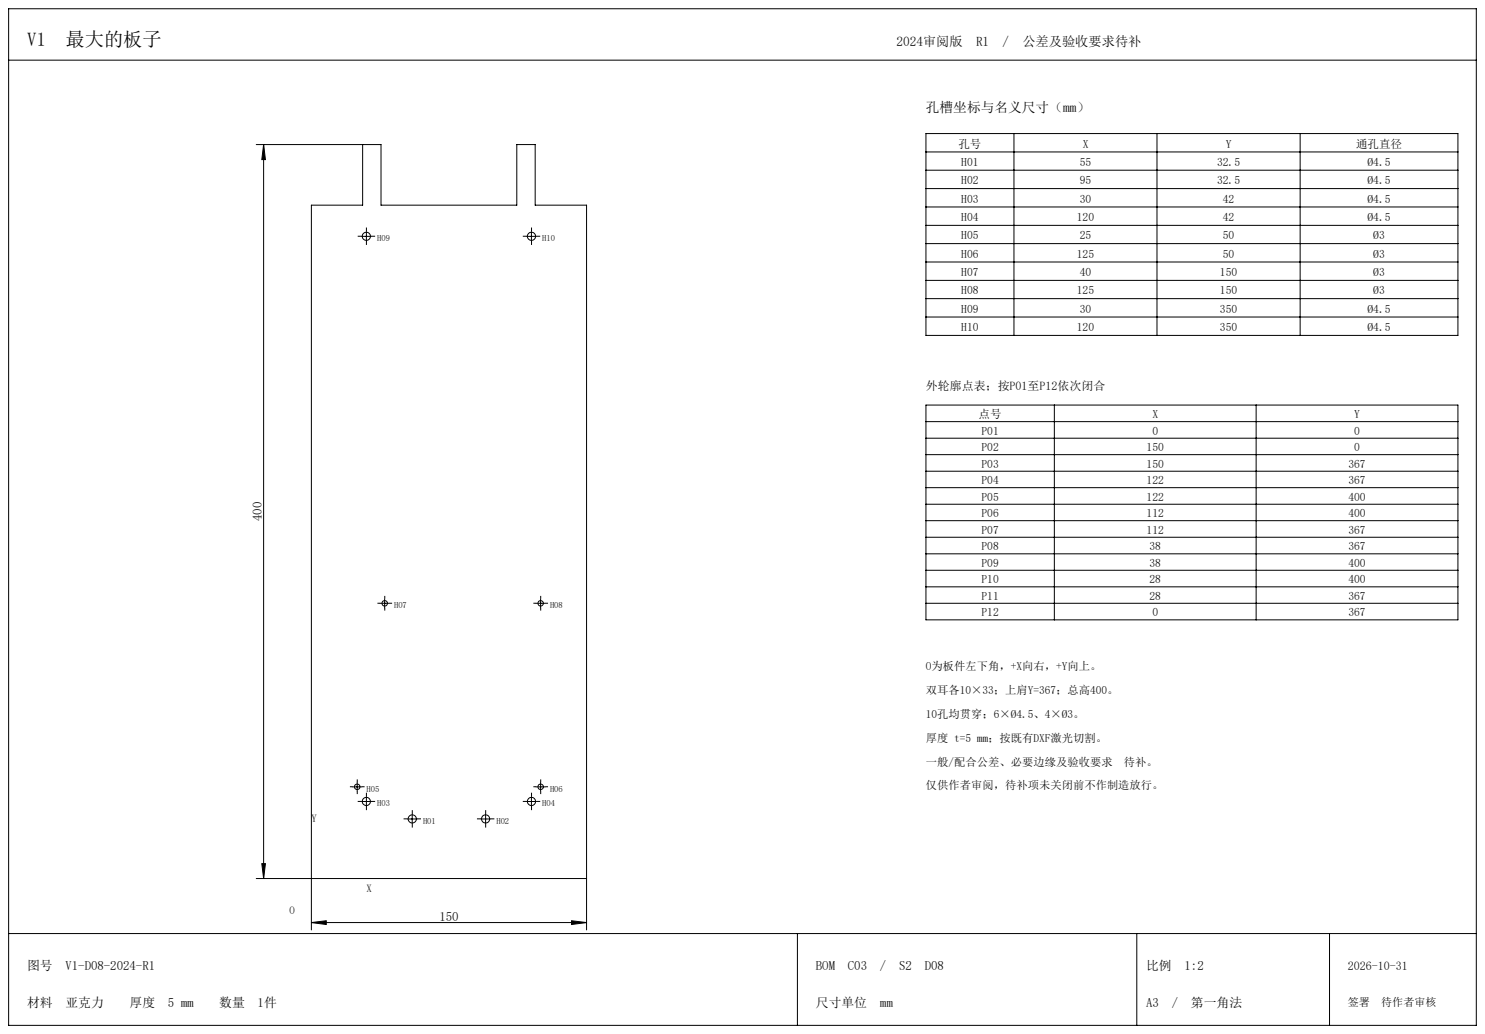
[picture p18: page 1]

孔号 | X | Y | 通孔直径
H01 | 55 | 32.5 | Ø4.5
H02 | 95 | 32.5 | Ø4.5
H03 | 30 | 42 | Ø4.5
H04 | 120 | 42 | Ø4.5
H05 | 25 | 50 | Ø3
H06 | 125 | 50 | Ø3
H07 | 40 | 150 | Ø3
H08 | 125 | 150 | Ø3
H09 | 30 | 350 | Ø4.5
H10 | 120 | 350 | Ø4.5

点号 | X | Y
P01 | 0 | 0
P02 | 150 | 0
P03 | 150 | 367
P04 | 122 | 367
P05 | 122 | 400
P06 | 112 | 400
P07 | 112 | 367
P08 | 38 | 367
P09 | 38 | 400
P10 | 28 | 400
P11 | 28 | 367
P12 | 0 | 367

一般/配合公差、必要边缘及验收要求 待补。
