zhu-chengdong/rov-v1-hardwarex/(commit log)

2026-11-02 Publish V1 hardware build documentation, author software and explicit licences
    [BOM.csv, dxf_circle_coordinates.csv, 孔槽名义尺寸与坐标_R1.csv]
2026-11-04 Update public engineering source bundle to v0.1.1
    Integrate confirmed R9 BOM, UTP wiring, manufacturing fits and processing documentation. Supply the three referenced metadata JSON files and portable data layout.
    Expose the previously bundled CAD, drawings and thermal records as browsable files, retain the unchanged v0.1.0 archive, and publish the complete 139-file v0.1.1 bundle with file and archive checksums.
    Keep CAD geometry, author software and existing temperature records unchanged relative to the v0.1.0 bundle. Preserve the established hardware, software and documentation licences. No manuscript, private history, third-party reference CAD or ROS bags are added.
    [AIR_20261014_190802_fixed_5min_bins.csv, AIR_20261014_190802_tegrastats_fields.csv, AIR_20261014_190802_temperature_source_data.csv, AIR_20261014_190802_temperature_statistics.csv, BOM.csv, BOM_cost_basis.csv, WATER_20261014_181314_fixed_5min_bins.csv, WATER_20261014_181314_tegrastats_fields.csv]
